jdat-zinoo/RocketGPStracker/README.md

# RocketGPStracker

Atmega328P (arduino based) tiny GPS tracker for model rockets.

Additional package:
https://github.com/SpenceKonde/ATTinyCore
JSon board URL: http://drazzy.com/package_drazzy.com_index.json

TinyWireM lib:
https://github.com/SpenceKonde/TinyWireM
