jdat-zinoo/RocketGPStracker/eagle/Master_BOM.ods

Qty | Value | Device | Package | Parts | Description | FARNELL | PROD_ID | TP_SIGNAL_NAME | VALUE
7 |  | LEDCHIPLED_0603 | 2426215
 |  |  | 2463989
1 | MOSFET-PCHANNEL | MOSFET-PCHANNEL | 2575107 |  | Generic PMOSFET |  | TRANS-08285
4 |  | MOSFET-NCHANNELBSS123LT1G | 2400359 |  | Common NMOSFET Parts |  | TRANS-08345
4 | ADP160 | 3V3 LDO | 2510377 |  | Nanopower LDO |  | VREG-11306 |  | ADP160
1 | LIS3MDL | LIS3MDL | RS 917-2725 |  | Digital output magnetic sensor: ultra-low-power high-performance 3-axis magnetometer
3 | MCP73831 | MCP73831 | 1834892 |  | Miniature single cell, fully integrated Li-Ion, Li-polymer charge management controller |  | IC-09995
1 | MS563702BA03 | MS563702BA03 | 2362663
2 | MC-405 | MC-405 | 2508596 |  |  |  |  |  | unknown | unknown
2 | 200mA/50V | MOSFET-NCHANNELBSS138 | 2357125 |  | Common NMOSFET Parts |  |  |  |  |  | TRANS-00830 | 200mA/50V
1 | ADP160 | 1V8 LDO | 2510505 |  | Nanopower LDO |  |  |  |  |  | VREG-11306 | ADP160
2 | RFM69HW | RFM69HW
1 | ORG1411 | ORG1411
1 | A2235-H | A2235-H
16 | 1X2 | 1X2
1 | Tiny45-20-SMT | ATTINY45TINY45-20-SMT |  |  |  |  | IC-08922 |  | Tiny45-20-SMT
14 | 100n | C-EUC0603
2 | 0.22uF | C-EUC0603
15 | 10uF | C-EUC0603
2 | 1n | C-EUC0603
4 | 22p | C-EUC0603
1 | 100n | C-EUC1206
8 | 0 | R-EU_R0603
4 | 2k2 | R-EU_R0603
7 | 220 | R-EU_R0603
9 | 100k | R-EU_R0603
3 | 470 | R-EU_R0603
9 | 10k | R-EU_R0603
1 | 5k1 | R-EU_R0603
2 | 3k | R-EU_R0603
2 | ATMEGA328P_TQFP | ATMEGA328P_TQFP |  |  |  |  |  |  |  |  | IC-09069 | ATMEGA328P_TQFP
2 | 2k2 | R-EU_R1206
2 |  | R-EU_R0603 | R0603 | R45, R46 | RESISTOR, European symbol
