jdat-zinoo/RocketGPStracker/eagle/flight.dxf

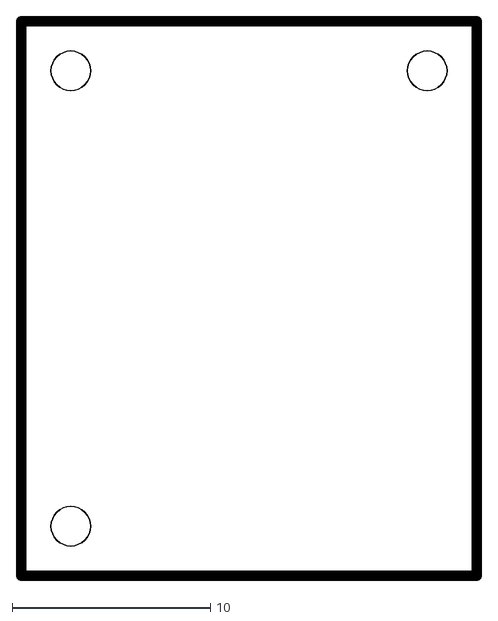
[picture p1: CAD file, 2017-05-08]
eagle/flight.dxf
23.5 x 28.5
