jdat-zinoo/RocketGPStracker/eagle/flight-mag3110.dxf

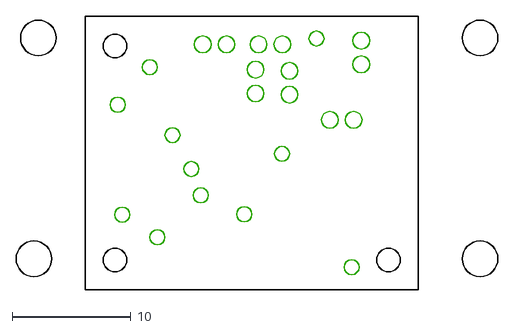
[picture p2: CAD file, 2017-05-08]
eagle/flight-mag3110.dxf
40.5 x 23.0
