jdat-zinoo/RocketGPStracker/eagle/gps_tracker_org1411.dxf

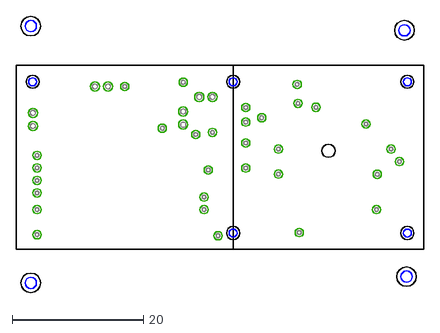
[picture p3: CAD file, 2017-05-08]
eagle/gps_tracker_org1411.dxf
62.0 x 42.1
