jdat-zinoo/RocketGPStracker/eagle/gps_tracker_A2235h.dxf

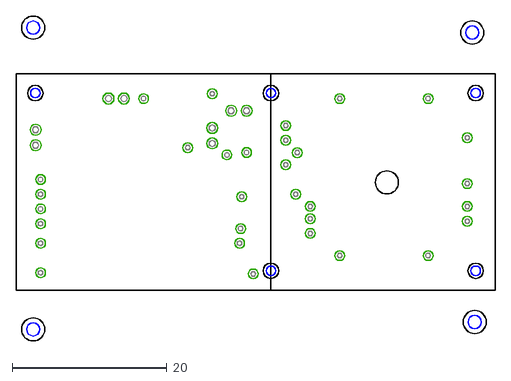
[picture p4: CAD file, 2017-05-08]
eagle/gps_tracker_A2235h.dxf
62.0 x 42.1
