jdat-zinoo/RocketGPStracker/eagle/gps_tracker_mark3.brd

## EAGLE design eagle/gps_tracker_mark3.brd (2017-05-08)

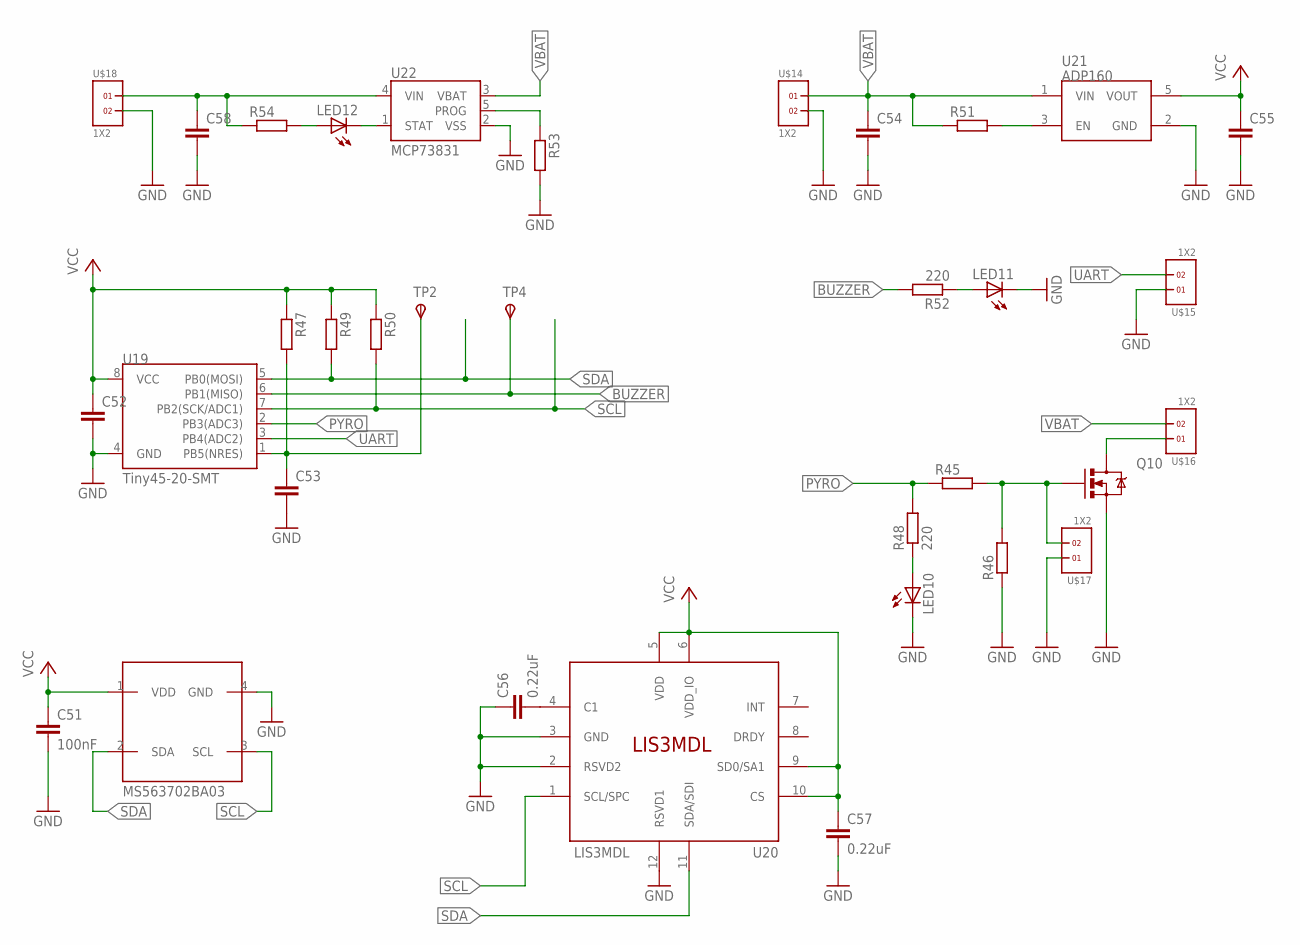
[picture p5: schematic gps_tracker_mark3.sch, sheet 1, Flight]

Parts:
C51: 100nF; C0603
C52: C-EUC1206; C1206
C53, C54, C55, C58: C-EUC0603; C0603
C56: 0.22uF; C0603K
C57: 0.22uF; C0603
IC2: MS563702BA03; MS5637
LED10, LED11: LEDCHIPLED_0805; CHIPLED_0805
LED12: LEDCHIPLED_0603; CHIPLED_0603
Q10: MOSFET-NCHANNELBSS123LT1G; SOT23-3
R45, R46, R47, R49, R50, R51, R53, R54: R-EU_R0603; R0603
R48, R52: 220; R0603
TP2, TP4: TPSB1,27; B1,27
U19: Tiny45-20-SMT; SO08-EIAJ
U20: LIS3MDL; VFLGA-12
U21: ADP160; SOT23-5; FARNELL 2510377
U22: MCP73831; SOT23-5; FARNELL 1834892
U$14, U$15, U$16, U$17, U$18: 1X2

Connections:
BUZZER: R52.2, TP4.TP, U19.6 (PB1(MISO))
GND: C51.2, C52.2, C53.2, C54.2, C55.2, C56.1, C57.2, C58.2, IC2.4 (GND), LED10.C, LED11.C, Q10.2 (S), R46.1, R53.2, U19.4 (GND), U20.2 (RSVD2), U20.3 (GND), U20.12 (RSVD1), U21.2 (GND), U22.2 (VSS), U$14.2, U$15.1, U$17.1, U$18.2
unnamed: C53.1, R47.2, TP2.TP, U19.1 (PB5(NRES))
unnamed: Q10.1 (G), R45.2, R46.2, U$17.2
unnamed: LED10.A, R48.1
unnamed: C56.2, U20.4 (C1)
unnamed: R51.2, U21.3 (EN)
unnamed: LED11.A, R52.1
unnamed: Q10.3 (D), U$16.1
unnamed: R53.1, U22.5 (PROG)
unnamed: LED12.C, U22.1 (STAT)
unnamed: LED12.A, R54.2
unnamed: C58.1, R54.1, U22.4 (VIN), U$18.1
PYRO: R45.1, R48.2, U19.2 (PB3(ADC3))
SCL: IC2.3 (SCL), R50.2, U19.7 (PB2(SCK/ADC1)), U20.1 (SCL/SPC)
SDA: IC2.2 (SDA), R49.2, U19.5 (PB0(MOSI)), U20.11 (SDA/SDI)
UART: U19.3 (PB4(ADC2)), U$15.2
VBAT: C54.1, R51.1, U21.1 (VIN), U22.3 (VBAT), U$14.1, U$16.2
VCC: C51.1, C52.1, C55.1, C57.1, IC2.1 (VDD), R47.1, R49.1, R50.1, U19.8 (VCC), U20.5 (VDD), U20.6 (VDD_IO), U20.9 (SD0/SA1), U20.10 (CS), U21.5 (VOUT)

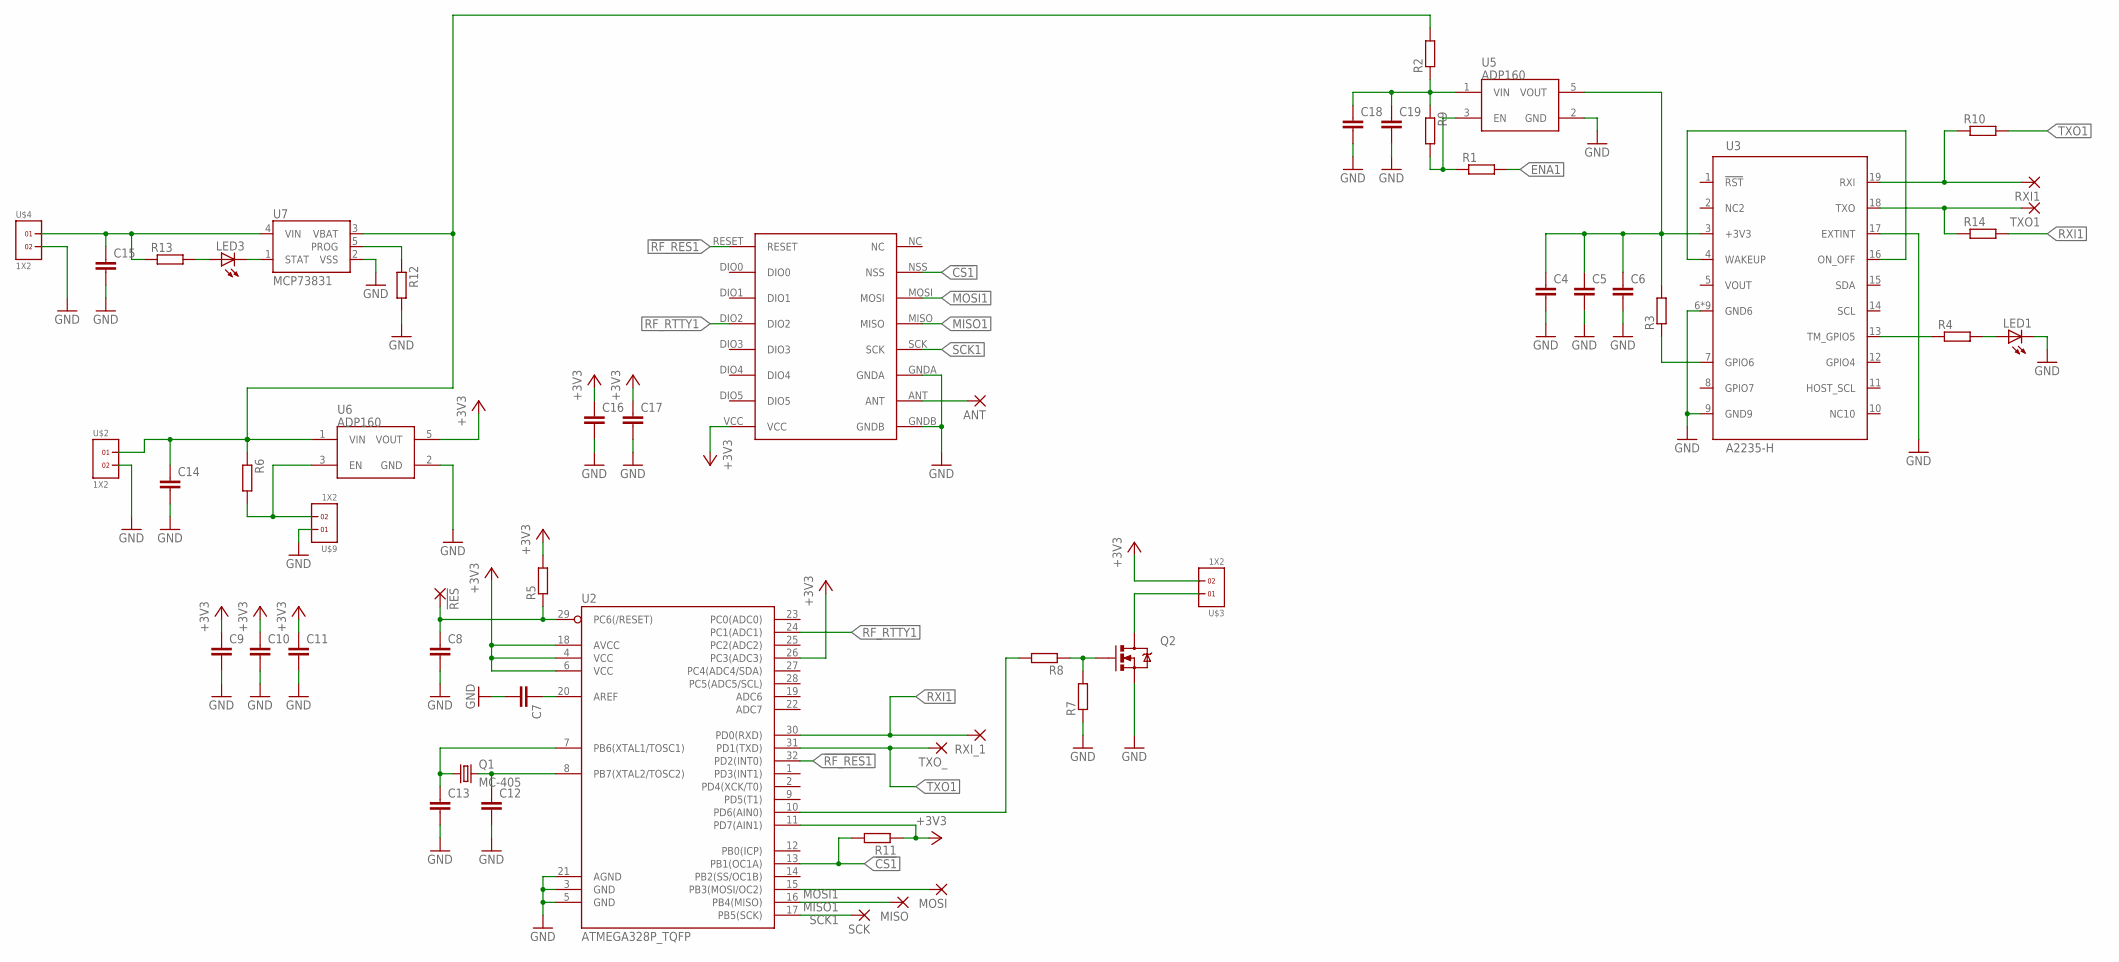
[picture p6: schematic gps_tracker_mark3.sch, sheet 2, A2235-H]

Parts:
!RES: SMD2; SMD1,27-2,54
ANT: SMD2; SMD1,27-2,54
C4, C5, C6, C7, C8, C9, C10, C11, C12, C13, C14, C15, C16, C17, C18, C19: C-EUC0603; C0603
LED1, LED3: LEDCHIPLED_0603; CHIPLED_0603
MISO: SMD2; SMD1,27-2,54
MOSI: SMD2; SMD1,27-2,54
Q1: MC-405; FARNELL 2508596
Q2: MOSFET-NCHANNELAO3404A; SOT23-3
R1, R2, R3, R4, R5, R6, R7, R8, R9, R10, R11, R12, R13, R14: R-EU_R0603; R0603
RXI1: SMD2; SMD1,27-2,54
RXI_1: SMD2; SMD1,27-2,54
SCK: SMD2; SMD1,27-2,54
TXO1: SMD2; SMD1,27-2,54
TXO_: SMD2; SMD1,27-2,54
U2: ATMEGA328P_TQFP; TQFP32-08
U3: A2235-H
U5, U6: ADP160; SOT23-5; FARNELL 2510377
U7: MCP73831; SOT23-5; FARNELL 1834892
U$1: RFM69HW; RFM
U$2, U$3, U$4, U$9: 1X2

Connections:
!CS1: R11.2, U2.13 (PB1(OC1A)), U$1.NSS
!RF_RES1: U2.32 (PD2(INT0)), U$1.RESET
+3V3_1: C9.1, C10.1, C11.1, C16.1, C17.1, R5.2, R11.1, U2.4 (VCC), U2.6 (VCC), U2.11 (PD7(AIN1)), U2.18 (AVCC), U2.26 (PC3(ADC3)), U6.5 (VOUT), U$1.VCC, U$3.2
+BAT1: C14.1, R2.2, R6.1, U6.1 (VIN), U7.3 (VBAT), U$2.1
ENA1: R1.2, R6.2, U6.3 (EN), U$9.2
GND1: C4.2, C5.2, C6.2, C7.2, C8.2, C9.2, C10.2, C11.2, C12.2, C13.2, C14.2, C15.2, C16.2, C17.2, C18.2, C19.2, LED1.C, Q2.2 (S), R7.1, R12.2, U2.3 (GND), U2.5 (GND), U2.21 (AGND), U3.6 (GND6), U3.9 (GND9), U3.17 (EXTINT), U3.101 (GND6), U3.102 (GND6), U3.103 (GND6), U3.104 (GND6), U3.105 (GND6), U3.106 (GND6), U3.107 (GND6), U3.108 (GND6), U5.2 (GND), U6.2 (GND), U7.2 (VSS), U$1.GNDA, U$1.GNDB, U$2.2, U$4.2, U$9.1
MISO1: MISO.1, U2.16 (PB4(MISO)), U$1.MISO
MOSI1: MOSI.1, U2.15 (PB3(MOSI/OC2)), U$1.MOSI
unnamed: R1.1, R9.2, U5.3 (EN)
unnamed: C18.1, C19.1, R2.1, R9.1, U5.1 (VIN)
unnamed: R3.1, U3.7 (GPIO6)
unnamed: LED1.A, R4.2
unnamed: R4.1, U3.13 (TM_GPIO5)
unnamed: U3.4 (WAKEUP), U3.16 (ON_OFF)
unnamed: R12.1, U7.5 (PROG)
unnamed: C7.1, U2.20 (AREF)
unnamed: !RES.1, C8.1, R5.1, U2.29 (PC6(/RESET))
unnamed: ANT.1, U$1.ANT
unnamed: C12.1, Q1.2, U2.8 (PB7(XTAL2/TOSC2))
unnamed: C13.1, Q1.1, U2.7 (PB6(XTAL1/TOSC1))
unnamed: LED3.C, U7.1 (STAT)
unnamed: Q2.1 (G), R7.2, R8.1
unnamed: R8.2, U2.10 (PD6(AIN0))
unnamed: Q2.3 (D), U$3.1
unnamed: LED3.A, R13.2
unnamed: C15.1, R13.1, U7.4 (VIN), U$4.1
unnamed: C4.1, C5.1, C6.1, R3.2, U3.3 (+3V3), U5.5 (VOUT)
RF_RTTY1: U2.24 (PC1(ADC1)), U$1.DIO2
RXI1: R14.2, RXI_1.1, U2.30 (PD0(RXD))
RXI_G1: R10.1, RXI1.1, U3.19 (RXI)
SCK1: SCK.1, U2.17 (PB5(SCK)), U$1.SCK
TXO1: R10.2, TXO_.1, U2.31 (PD1(TXD))
TXO_G1: R14.1, TXO1.1, U3.18 (TXO)
VOUT: U3.5 (VOUT)

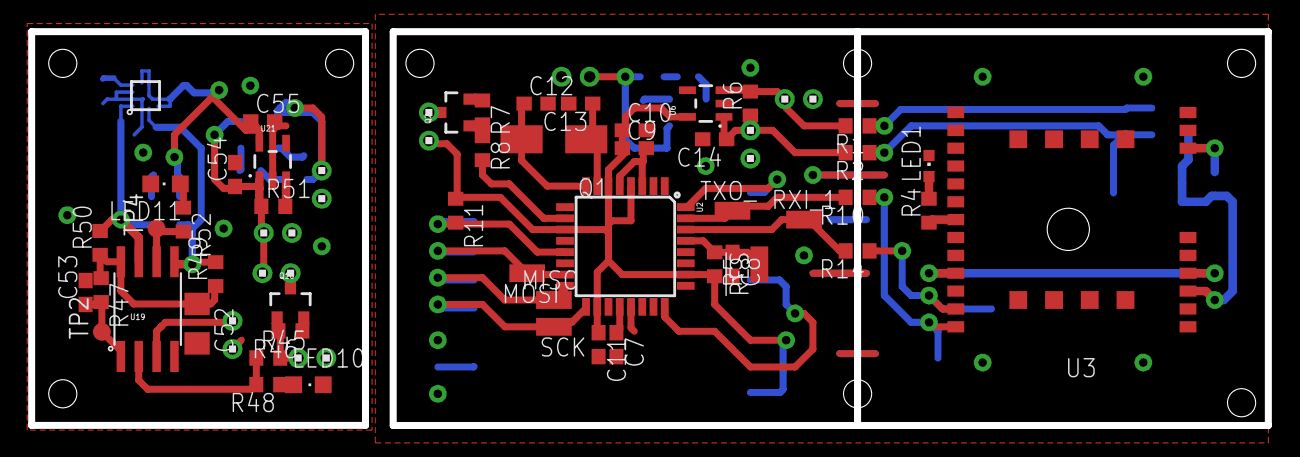
[picture p7: board gps_tracker_mark3.brd from above]

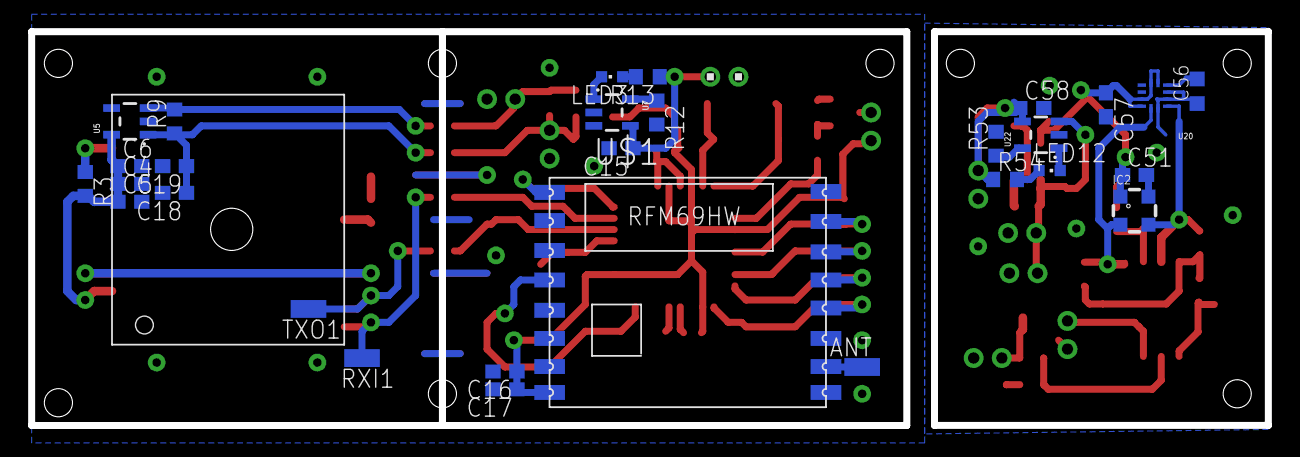
[picture p8: board gps_tracker_mark3.brd from below]

Board: 2 copper layers, 87.9 x 28.0 mm, 87 parts (30 on the bottom side), 52 nets.
