jdat-zinoo/RocketGPStracker/eagle/gps_tracker_org1411.brd

## EAGLE design eagle/gps_tracker_org1411.brd (2017-05-08)

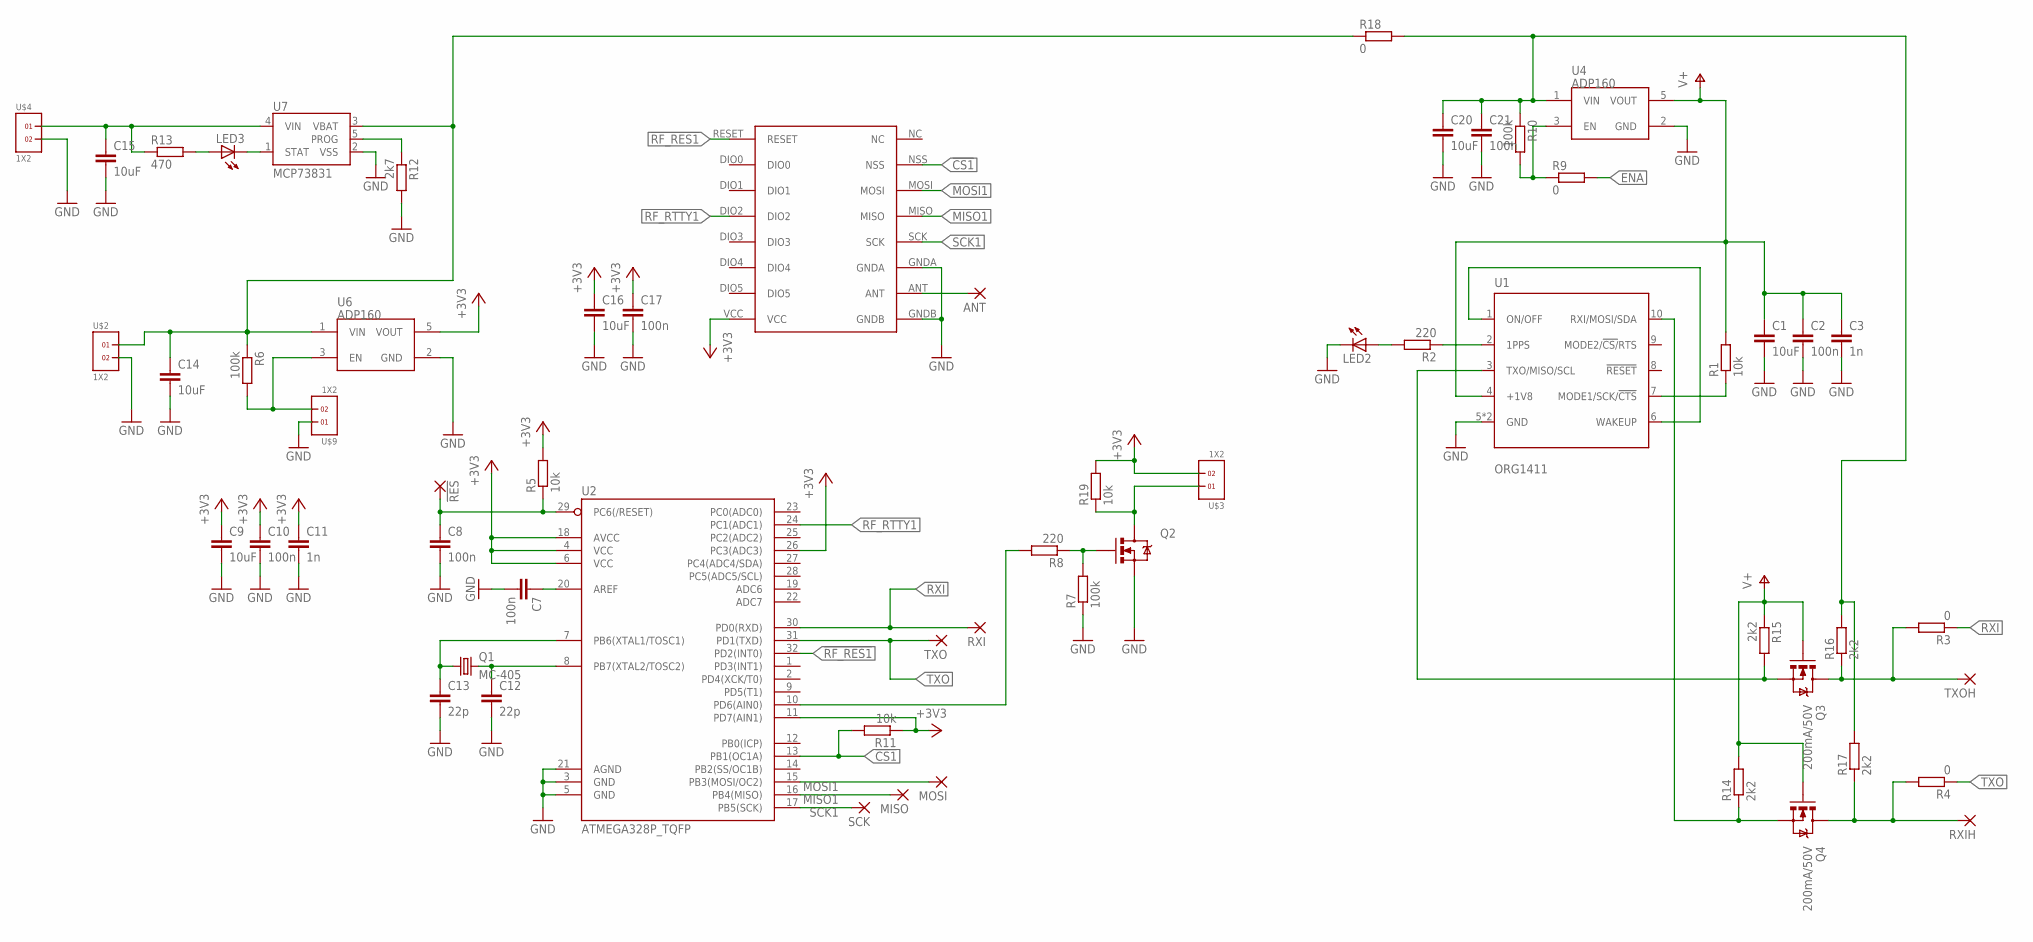
[picture p9: schematic gps_tracker_org1411.sch, sheet 1]

Parts:
!RES: SMD2; SMD1,27-2,54
ANT: SMD2; SMD1,27-2,54
C1, C9, C14, C15, C16, C20: 10uF; C0603
C2, C7, C8, C10, C17, C21: 100n; C0603
C3, C11: 1n; C0603
C12, C13: 22p; C0603
LED2, LED3: LEDCHIPLED_0603; CHIPLED_0603
MISO: SMD2; SMD1,27-2,54
MOSI: SMD2; SMD1,27-2,54
Q1: MC-405; FARNELL 2508596
Q2: MOSFET-NCHANNELAO3404A; SOT23-3
Q3, Q4: 200mA/50V; SOT23-3
R1, R5, R11, R19: 10k; R0603
R2, R8: 220; R0603
R3, R4, R9, R18: 0; R0603
R6, R7, R10: 100k; R0603
R12: 2k7; R0603
R13: 470; R0603
R14, R15: 2k2; R0603
R16, R17: 2k2; R1206
RXI: SMD2; SMD1,27-2,54
RXIH: SMD2; SMD1,27-2,54
SCK: SMD2; SMD1,27-2,54
TXO: SMD2; SMD1,27-2,54
TXOH: SMD2; SMD1,27-2,54
U1: ORG1411
U2: ATMEGA328P_TQFP; TQFP32-08
U4: ADP160; SOT23-5; FARNELL 2510505
U6: ADP160; SOT23-5; FARNELL 2510377
U7: MCP73831; SOT23-5; FARNELL 1834892
U$2, U$3, U$4, U$9: 1X2
U$5: RFM69HW; RFM

Connections:
!CS1: R11.2, U2.13 (PB1(OC1A)), U$5.NSS
!RF_RES1: U2.32 (PD2(INT0)), U$5.RESET
+3V3_1: C9.1, C10.1, C11.1, C16.1, C17.1, R5.2, R11.1, R19.2, U2.4 (VCC), U2.6 (VCC), U2.11 (PD7(AIN1)), U2.18 (AVCC), U2.26 (PC3(ADC3)), U6.5 (VOUT), U$3.2, U$5.VCC
+BAT: C14.1, R6.1, R18.1, U6.1 (VIN), U7.3 (VBAT), U$2.1
ENA: R6.2, R9.2, U6.3 (EN), U$9.2
GND: C1.2, C2.2, C3.2, C7.2, C8.2, C9.2, C10.2, C11.2, C12.2, C13.2, C14.2, C15.2, C16.2, C17.2, C20.2, C21.2, LED2.C, Q2.2 (S), R7.1, R12.2, U1.5 (GND), U1.11 (GND), U2.3 (GND), U2.5 (GND), U2.21 (AGND), U4.2 (GND), U6.2 (GND), U7.2 (VSS), U$2.2, U$4.2, U$5.GNDA, U$5.GNDB, U$9.1
MISO1: MISO.1, U2.16 (PB4(MISO)), U$5.MISO
MOSI1: MOSI.1, U2.15 (PB3(MOSI/OC2)), U$5.MOSI
N1: R9.1, R10.2, U4.3 (EN)
unnamed: U1.1 (ON/OFF), U1.6 (WAKEUP)
unnamed: R1.1, U1.7 (MODE1/SCK/!CTS)
unnamed: R2.1, U1.2 (1PPS)
unnamed: LED2.A, R2.2
unnamed: Q3.2 (S), R15.2, U1.3 (TXO/MISO/SCL)
unnamed: C20.1, C21.1, R10.1, R16.2, R17.2, R18.2, U4.1 (VIN)
unnamed: R12.1, U7.5 (PROG)
unnamed: C7.1, U2.20 (AREF)
unnamed: !RES.1, C8.1, R5.1, U2.29 (PC6(/RESET))
unnamed: ANT.1, U$5.ANT
unnamed: C12.1, Q1.2, U2.8 (PB7(XTAL2/TOSC2))
unnamed: C13.1, Q1.1, U2.7 (PB6(XTAL1/TOSC1))
unnamed: LED3.C, U7.1 (STAT)
unnamed: Q2.1 (G), R7.2, R8.1
unnamed: R8.2, U2.10 (PD6(AIN0))
unnamed: Q2.3 (D), R19.1, U$3.1
unnamed: LED3.A, R13.2
unnamed: C15.1, R13.1, U7.4 (VIN), U$4.1
unnamed: Q3.3 (D), R3.2, R16.1, TXOH.1
unnamed: Q4.3 (D), R4.2, R17.1, RXIH.1
unnamed: Q4.2 (S), R14.1, U1.10 (RXI/MOSI/SDA)
RF_RTTY1: U2.24 (PC1(ADC1)), U$5.DIO2
RXI: R3.1, RXI.1, U2.30 (PD0(RXD))
SCK1: SCK.1, U2.17 (PB5(SCK)), U$5.SCK
TXO: R4.1, TXO.1, U2.31 (PD1(TXD))
V+: C1.1, C2.1, C3.1, Q3.1 (G), Q4.1 (G), R1.2, R14.2, R15.1, U1.4 (+1V8), U4.5 (VOUT)

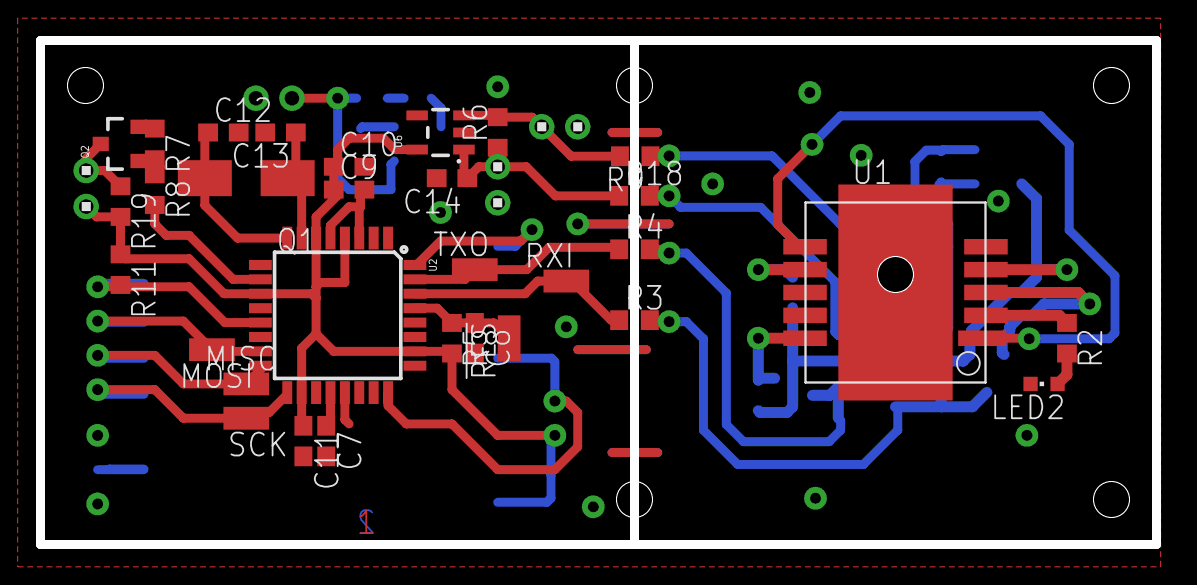
[picture p10: board gps_tracker_org1411.brd from above]

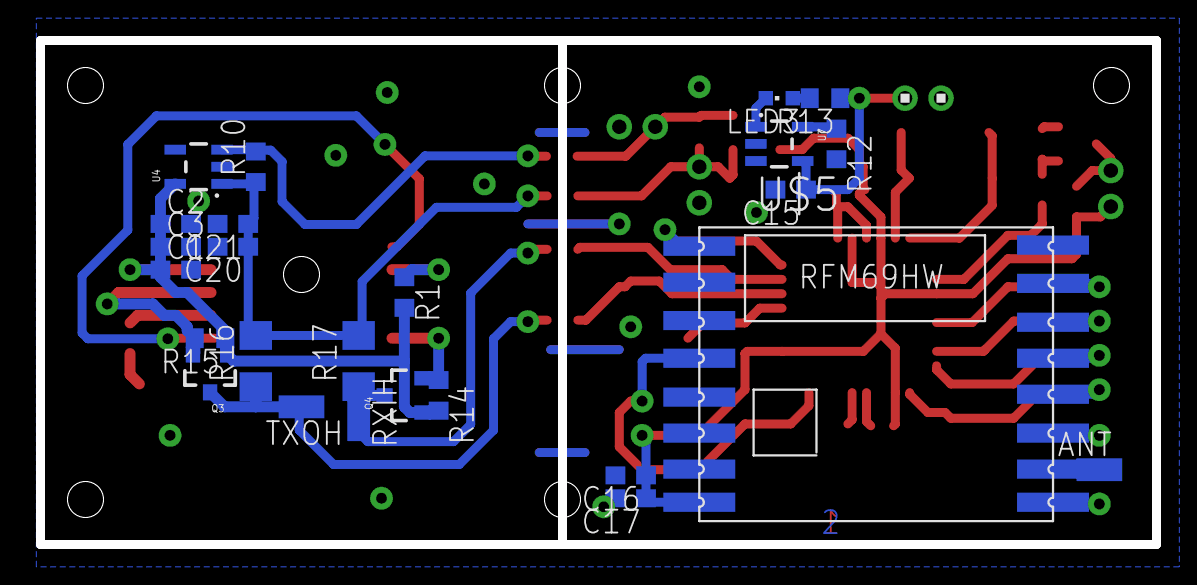
[picture p11: board gps_tracker_org1411.brd from below]

Board: 2 copper layers, 62.0 x 28.0 mm, 60 parts (26 on the bottom side), 35 nets.
