jdat-zinoo/RocketGPStracker/(commit log)

2017-07-29 tracker code update
    tracker code update to HW version 2.
    RTTY TX pin now is PORTC 2
2018-02-10 Fixed frequency to 868 MHz and shift to 850 Hz
    [tracker.ino]
