jdat-zinoo/RocketGPStracker/(notices)

Notices in the files:
flightTiny/Eeprom24C512.cpp:
the terms of the GNU Lesser General Public License as published by the Free
rocket-tracker-rtty-868/tracker/RFM69OOK.h:
Copyright Felix Rusu (2014), felix@lowpowerlab.com
parts and their libraries:
SparkFun-DigitalIC: Licensing: Creative Commons ShareAlike 4.0 International - https://creativecommons.org/licenses/by-sa/4.0
freetronics-original: Licensing: CC v3.0 Share-Alike You are welcome to use this library for commercial purposes.
